PurdueROV-Archive/X9-PCB-Backplane-Shield/X8-Backplane.brd

## EAGLE design X8-Backplane.brd (2016-12-30)

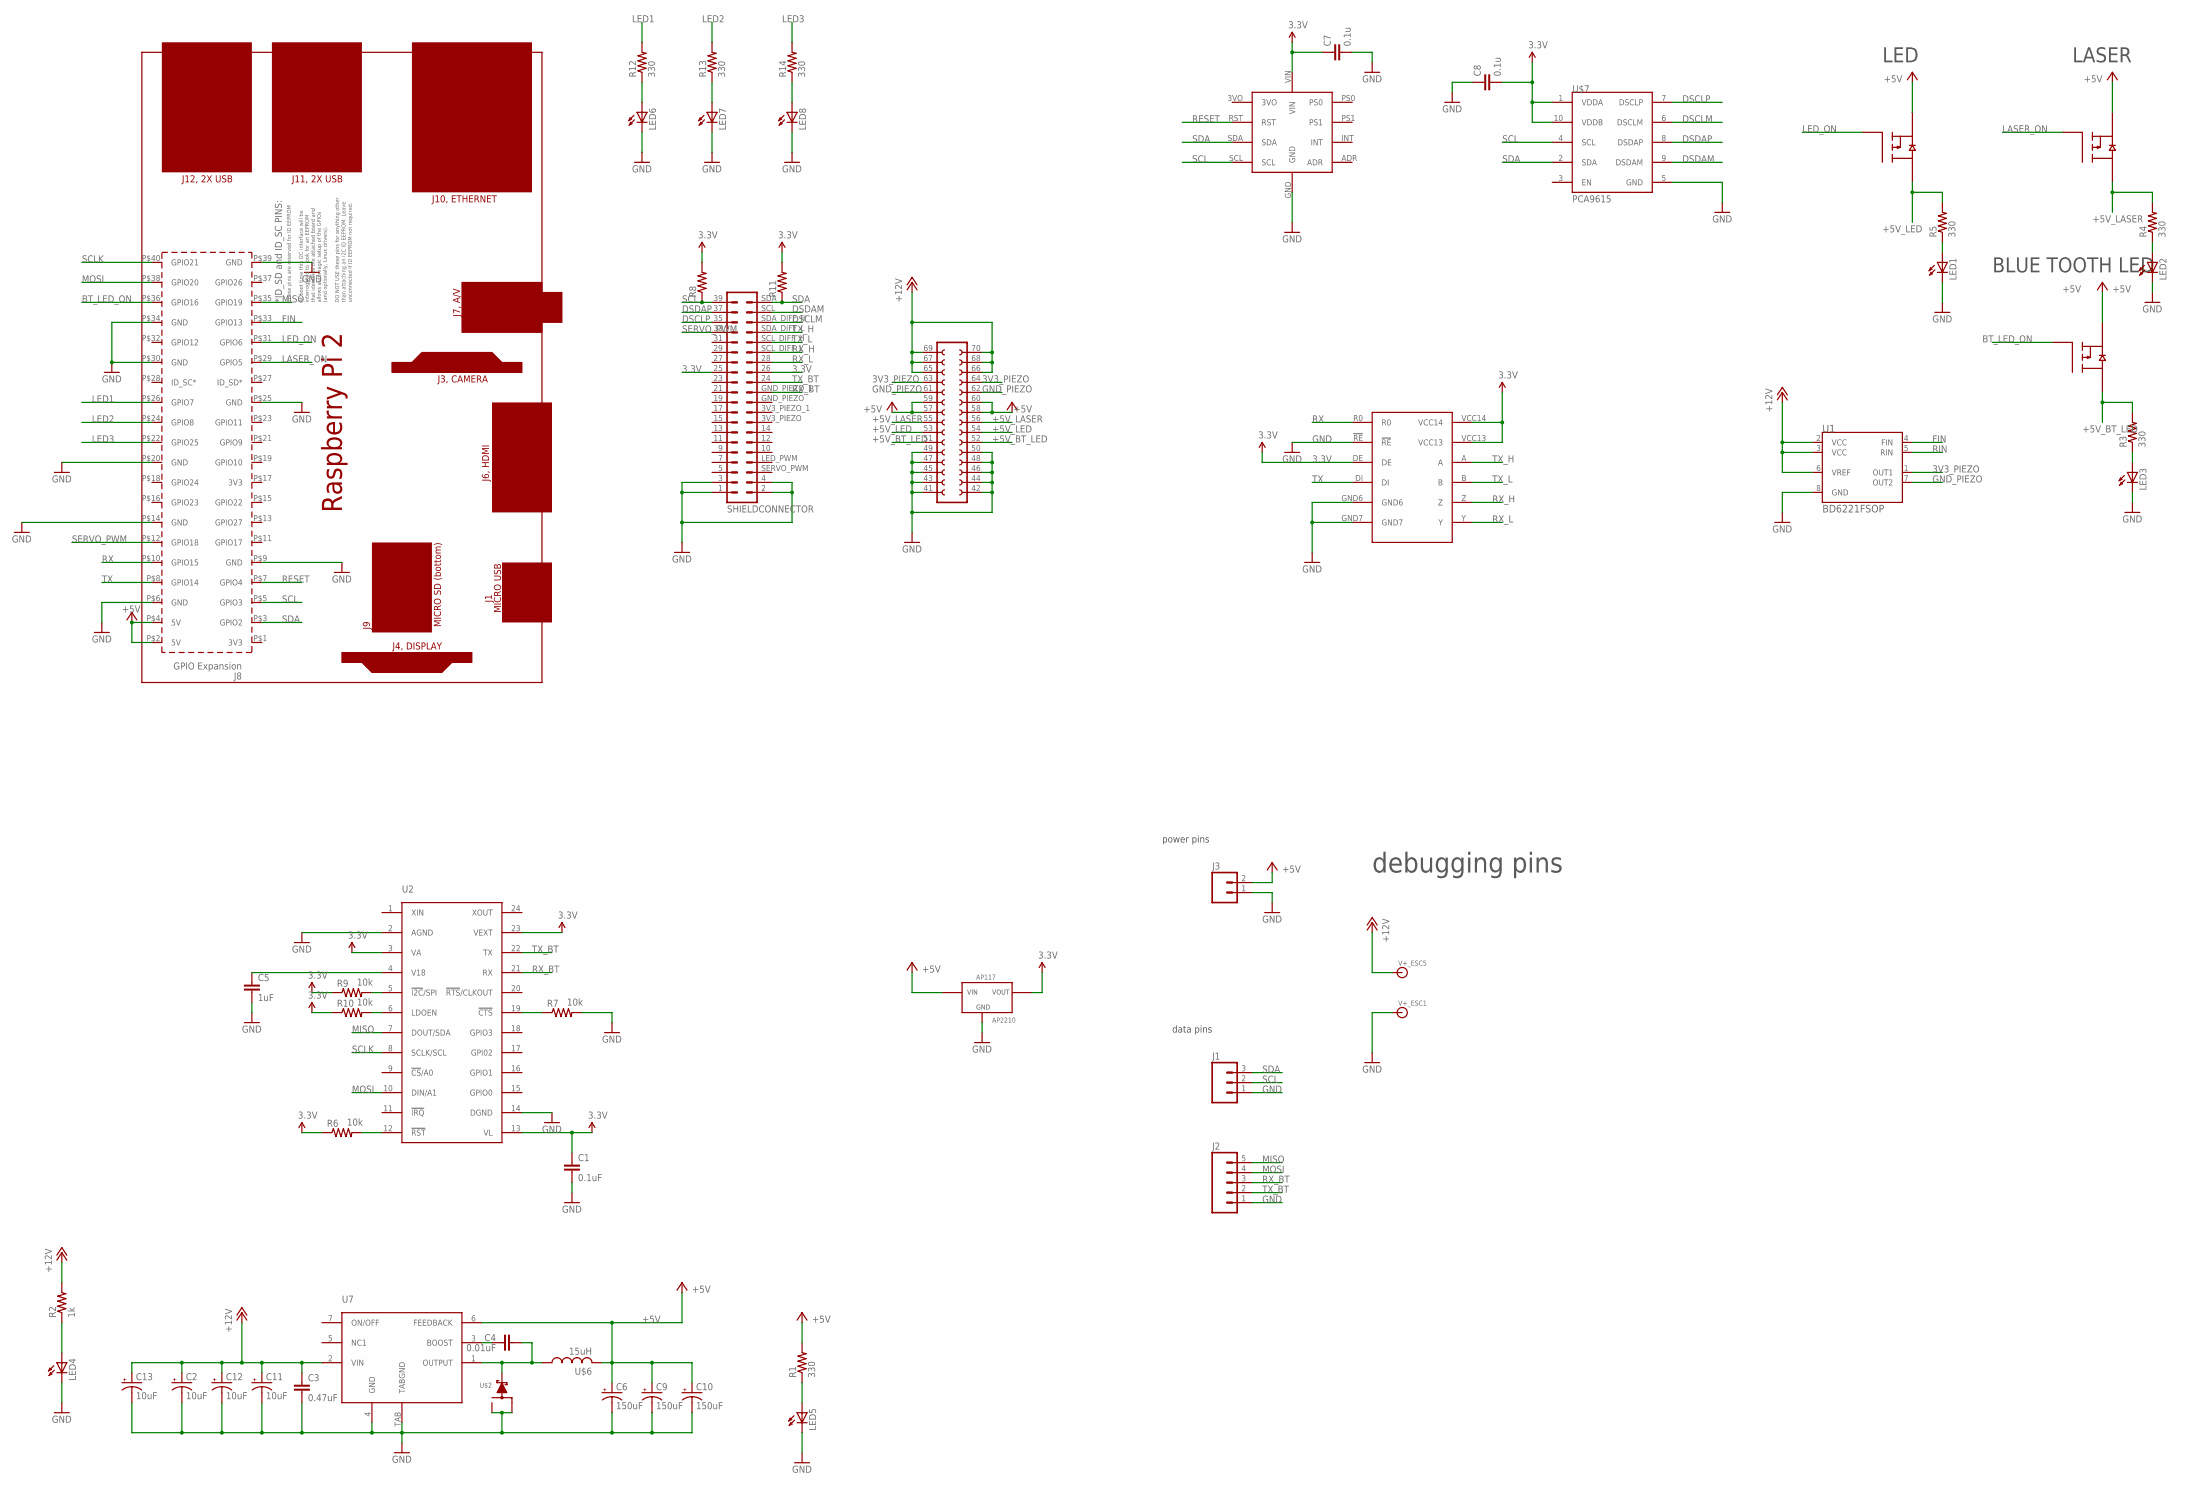
[picture p1: schematic X8-Backplane.sch]

Parts:
C1: 0.1uF; 0603-CAP
C2, C11, C12, C13: 10uF; CTAN(7.30_4.30MM)
C3: 0.47uF; 0603
C4: 0.01uF; 0603-CAP
C5: 1uF; 0603-CAP
C6, C9, C10: 150uF; CTAN(7.30_4.30MM)
C7, C8: 0.1u; 0603-CAP
J1: M03PTH; 1X03
J2: M05PTH; 1X05
J3: M02PTH; 1X02
LED1, LED2, LED3, LED4, LED5, LED6, LED7, LED8: LEDSML0603; SML0603
PCB1: RPI2
R1, R3, R4, R5, R12, R13, R14: 330; R0603
R2: 1k; R0603
R6, R7, R9, R10: 10k; 0603-RES
R8, R11: RESISTOR0603-RES; 0603-RES
U1: BD6221FSOP; SOP8
U2: MAX3107SSOP; SSOP-24
U4, U5, U6: FQB27P06; TO263-3
U7: LM2678
U$1: MAX3491
U$2: SWITCHMODE_SCHOTTKY; DPAK-3
U$3: BNO055_9DOF_BREAKOUT; BNO055
U$4: SHIELDCONNECTOR; 20X2PIN
U$5: AP2210; SOT-23-3
U$6: 15uH; HCMA1305
U$7: PCA9615; MSOP_10
V+_ESC1, V+_ESC5: BANANA_CONN

Connections:
3.3V: C1.1, C7.1, C8.2, R6.1, R8.2, R9.1, R10.1, R11.2, U2.3 (VA), U2.13 (VL), U2.23 (VEXT), U$1.DE, U$1.VCC13, U$1.VCC14, U$3.VIN, U$4.25, U$4.26, U$5.VOUT, U$7.1 (VDDA), U$7.10 (VDDB)
3V3_PIEZO: U1.1 (OUT1), U$4.63 (23), U$4.64 (24)
+5V: C6.+, C9.+, C10.+, J3.2, PCB1.P$2 (5V), PCB1.P$4 (5V), R1.2, U4.3 (S2), U5.3 (S2), U6.3 (S2), U7.6 (FEEDBACK), U$4.57 (17), U$4.58 (18), U$4.59 (19), U$4.60 (20), U$5.VIN, U$6.P$2 (2)
+5V_BT_LED: R3.2, U6.TAB (D2), U$4.51 (11), U$4.52 (12)
+5V_LASER: R4.2, U5.TAB (D2), U$4.55 (15), U$4.56 (16)
+5V_LED: R5.2, U4.TAB (D2), U$4.53 (13), U$4.54 (14)
+12V: C2.+, C3.1, C11.+, C12.+, C13.+, R2.2, U1.2 (VCC), U1.3 (VCC), U1.6 (VREF), U7.2 (VIN), U$4.65 (25), U$4.66 (26), U$4.67 (27), U$4.68 (28), U$4.69 (12V), U$4.70 (30), V+_ESC5.P$1
BT_LED_ON: PCB1.P$36 (GPIO16), U6.1 (G2)
DSCLM: U$4.SDA_DIFF_H, U$7.6 (DSCLM)
DSCLP: U$4.35, U$7.7 (DSCLP)
DSDAM: U$4.SCL, U$7.9 (DSDAM)
DSDAP: U$4.37, U$7.8 (DSDAP)
FIN: PCB1.P$33 (GPIO13), U1.4 (FIN)
GND: C1.2, C2.-, C3.2, C5.2, C6.-, C7.2, C8.1, C9.-, C10.-, C11.-, C12.-, C13.-, J1.1, J2.1, J3.1, LED1.C, LED2.C, LED3.C, LED4.C, LED5.C, LED6.C, LED7.C, LED8.C, PCB1.P$6 (GND), PCB1.P$9 (GND), PCB1.P$14 (GND), PCB1.P$20 (GND), PCB1.P$25 (GND), PCB1.P$30 (GND), PCB1.P$34 (GND), PCB1.P$39 (GND), R7.2, U1.8 (GND), U2.2 (AGND), U2.14 (DGND), U7.4 (GND), U7.TAB (TABGND), U$1.!RE, U$1.GND6, U$1.GND7, U$2.P$1, U$2.P$3, U$3.GND, U$4.1, U$4.2, U$4.3, U$4.4, U$4.41 (1), U$4.42 (2), U$4.43 (3), U$4.44 (4), U$4.45 (5), U$4.46 (6), U$4.47 (7), U$4.48 (8), U$4.49 (9), U$4.50 (10), U$5.GND, U$7.5 (GND), V+_ESC1.P$1
GND_PIEZO: U1.7 (OUT2), U$4.61 (21), U$4.62 (22)
LASER_ON: PCB1.P$29 (GPIO5), U5.1 (G2)
LED1: PCB1.P$26 (GPIO7), R12.2
LED2: PCB1.P$24 (GPIO8), R13.2
LED3: PCB1.P$22 (GPIO25), R14.2
LED_ON: PCB1.P$31 (GPIO6), U4.1 (G2)
MISO: J2.5, PCB1.P$35 (GPIO19), U2.7 (DOUT/SDA)
MOSI: J2.4, PCB1.P$38 (GPIO20), U2.10 (DIN/A1)
unnamed: LED5.A, R1.1
unnamed: LED4.A, R2.1
unnamed: LED1.A, R5.1
unnamed: LED2.A, R4.1
unnamed: LED3.A, R3.1
unnamed: R6.2, U2.12 (!RST!)
unnamed: R7.1, U2.19 (!CTS!)
unnamed: C5.1, U2.4 (V18)
unnamed: R9.2, U2.5 (!I2C!/SPI)
unnamed: R10.2, U2.6 (LDOEN)
unnamed: LED6.A, R12.1
unnamed: LED7.A, R13.1
unnamed: LED8.A, R14.1
unnamed: C4.1, U7.3 (BOOST)
unnamed: C4.2, U7.1 (OUTPUT), U$2.P$4, U$6.P$1 (1)
RESET: PCB1.P$7 (GPIO4), U$3.RST
RIN: U1.5 (RIN)
RX: PCB1.P$10 (GPIO15), U$1.R0
RX_BT: J2.3, U2.21 (RX), U$4.GND_PIEZO_1
RX_H: U$1.Z, U$4.SCL_DIFF_L
RX_L: U$1.Y, U$4.28
SCL: J1.2, PCB1.P$5 (GPIO3), R8.1, U$3.SCL, U$4.39, U$7.4 (SCL)
SCLK: PCB1.P$40 (GPIO21), U2.8 (SCLK/SCL)
SDA: J1.3, PCB1.P$3 (GPIO2), R11.1, U$3.SDA, U$4.SDA, U$7.2 (SDA)
SERVO_PWM: PCB1.P$12 (GPIO18), U$4.33
TX: PCB1.P$8 (GPIO14), U$1.DI
TX_BT: J2.2, U2.22 (TX), U$4.24
TX_H: U$1.A, U$4.SDA_DIFF_L
TX_L: U$1.B, U$4.SCL_DIFF_H

Notes on the sheet:
LED
LASER
BLUE TOOTH LED
debugging pins
power pins
data pins

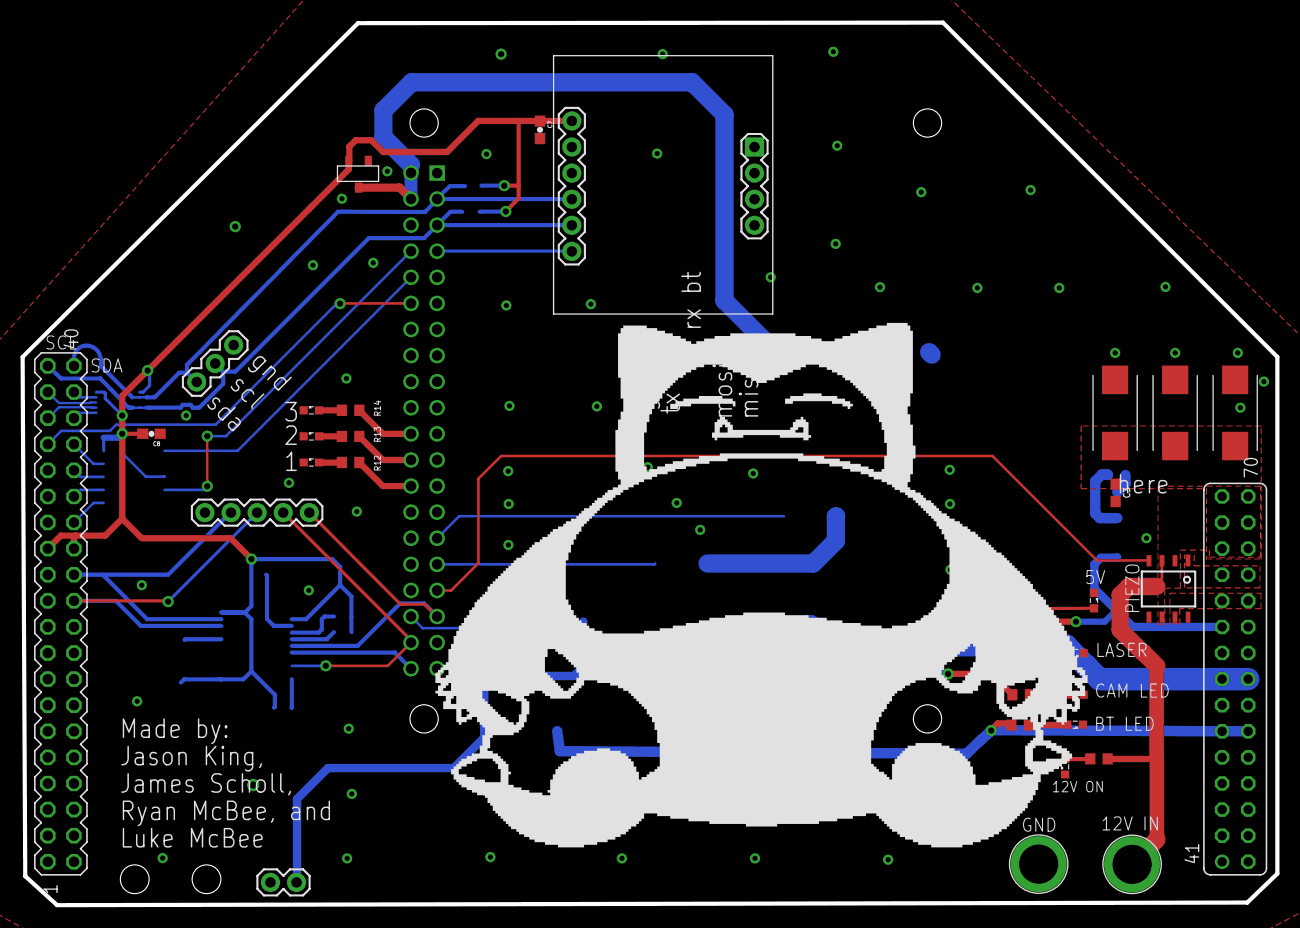
[picture p2: board X8-Backplane.brd from above]

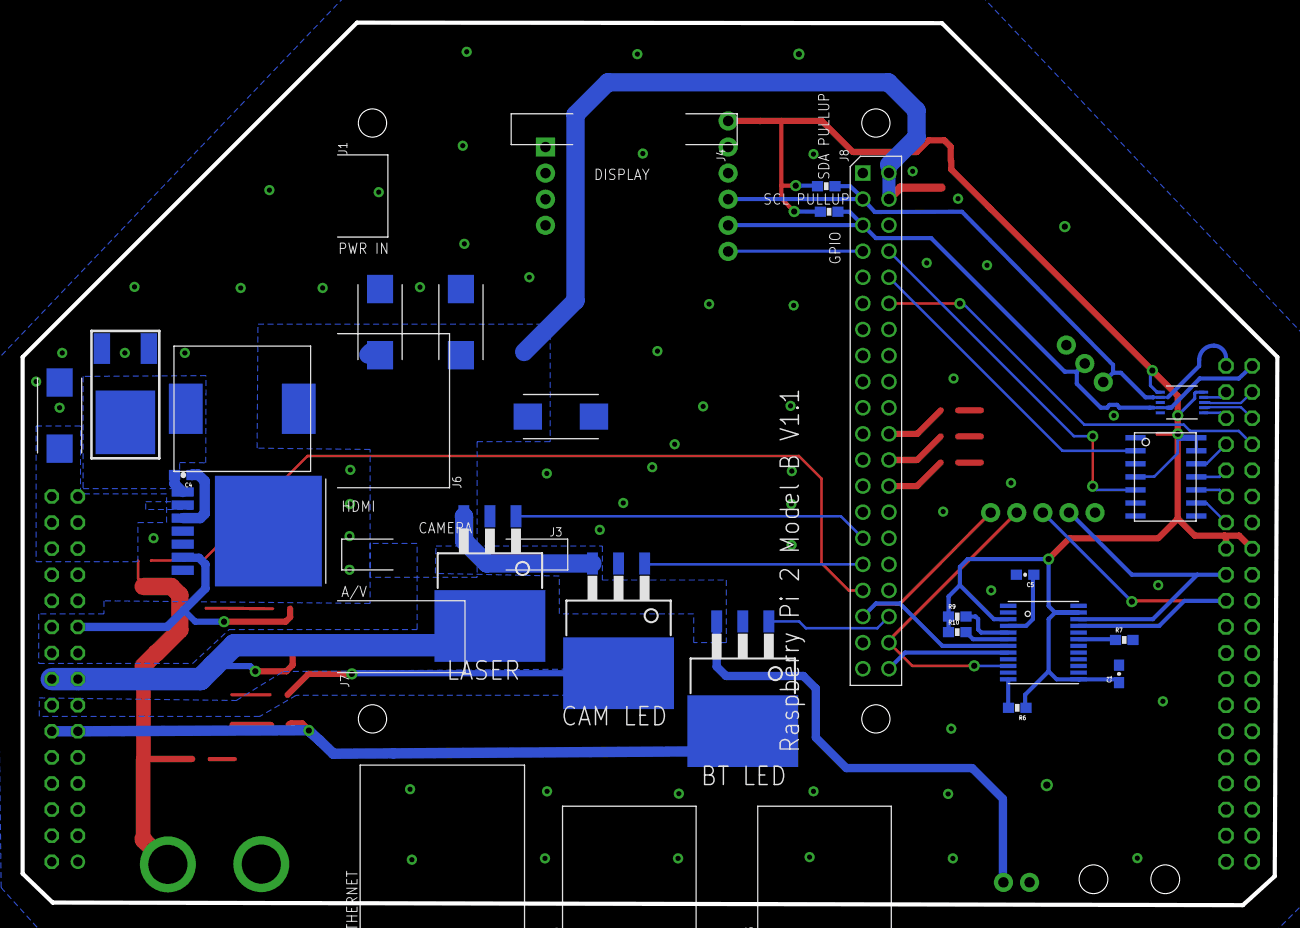
[picture p3: board X8-Backplane.brd from below]

Board: 2 copper layers, 122.1 x 85.9 mm, 54 parts (23 on the bottom side), 50 nets.
