PurdueROV-Archive/X9-PCB-Backplane-Shield/(commit log)

2016-11-02 Added part for raspberry pi, 5V -> 3.3V buck converter, and IMU pins
    [X8-Backplane.brd, X8-Backplane.sch]
2016-11-03 changed outside perimeter
    [Backplane-Shield.brd, Backplane-Shield.sch]
2016-11-03 small modification to outline
    [X8-Backplane.brd]
2016-11-05 Intermediate layout
    [X8-Backplane.brd]
2016-11-05 Finished preliminary layout - probably needs revision
    [X8-Backplane.brd]
2016-11-06 added brd to brd connector
    [X8-Backplane.brd, X8-Backplane.sch]
2016-11-12 because I can
    [X8-Backplane.brd, X8-Backplane.sch]
2016-11-16 Mostly routed
    [X8-Backplane.brd, X8-Backplane.sch]
2016-11-24 removed buck regulator circuit
    [X8-Backplane.brd, X8-Backplane.sch]
2016-11-24 added some new parts
    [X8-Backplane.brd, X8-Backplane.sch]
2016-11-24 finished adding components, added descriptions of pins
    [X8-Backplane.brd, X8-Backplane.sch]
2016-11-25 first draft of the sechematic. Almost there!
    [X8-Backplane.brd, X8-Backplane.sch]
2016-11-25 Added a mosfet for an led for the blue tooth
    [Backplane-Shield.brd, Backplane-Shield.sch, X8-Backplane.brd, X8-Backplane.sch]
2016-11-27 Started initial routing on the board
    [X8-Backplane.brd, X8-Backplane.sch]
2016-11-27 Leaving the rest to Ryan, not sure I can work with the layout given to me
    [X8-Backplane.brd]
2016-11-30 Redid routing and moved components
    [X8-Backplane.brd, X8-Backplane.sch]
2016-11-30 Moved some more components and added vias to reconnect isolated grounds
    [X8-Backplane.brd]
2016-12-04 Almost done with routing - stil have to add vias and extra debugging pinouts
    [X8-Backplane.brd, X8-Backplane.sch]
2016-12-04 Finished routing except for any debug pins and possible extra vias
    [X8-Backplane.brd, X8-Backplane.sch]
2016-12-04 minor changes by Ryan
    [X8-Backplane.brd, X8-Backplane.sch]
2016-12-04 made the bottom flat
    [X8-Backplane.brd]
2016-12-04 added buck regulator
    [X8-Backplane.brd, X8-Backplane.sch]
2016-12-04 added more gnd vias
    [X8-Backplane.brd]
2016-12-07 Moved the buck regulator parts
    [X8-Backplane.brd]
2016-12-07 To be reviewed
    [X8-Backplane.brd]
2016-12-07 minor tweaks
    [X8-Backplane.brd]
2016-12-10 modified wiring of buck regulator
    [X8-Backplane.brd]
2016-12-10 added LEDs
    [X8-Backplane.brd, X8-Backplane.sch]
2016-12-10 added SPI to UART ship
    [X8-Backplane.brd, X8-Backplane.sch]
2016-12-11 Wired the spi to serial circuit
    [X8-Backplane.brd, X8-Backplane.sch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]
2016-12-15 almost done reviewing the board
    [X8-Backplane.brd, X8-Backplane.sch]
2016-12-18 add holes for possible usb hub mount
    [X8-Backplane.brd]
2016-12-19 added two gnd vias
    [X8-Backplane.brd]
2016-12-21 Fixed routing issues
    [X8-Backplane.brd, X8-Backplane.sch]
2016-12-23 modified the silkscreen
    [X8-Backplane.brd]
2016-12-23 added names
    [X8-Backplane.brd]
2016-12-24 minor changes to i2c lines
    [X8-Backplane.brd]
2016-12-26 cleaned up gnd plane and added labels
    [X8-Backplane.brd, X8-Backplane.sch]
2016-12-28 added snorlax!
    [X8-Backplane.brd, X8-Backplane.sch]
2016-12-29 minor changes
    [X8-Backplane.brd]
2016-12-30 Edited the silkscreen
    [X8-Backplane.brd]
